PhischDotOrg/stm32f1-blinkenbike/README.md

# stm32f1-blinkenbike
Blinkenlight for Kids Bicycle based on a STM32F1 "Blue Pill" Board using an STM32F103 µC along with an WS2812b Strip.

# How to build
See the documentation for the common reposority at [https://github.com/PhischDotOrg/stm32-common](https://github.com/PhischDotOrg/stm32-common).
