PhischDotOrg/stm32f1-blinkenbike/hw/BlinkenBike.pdf

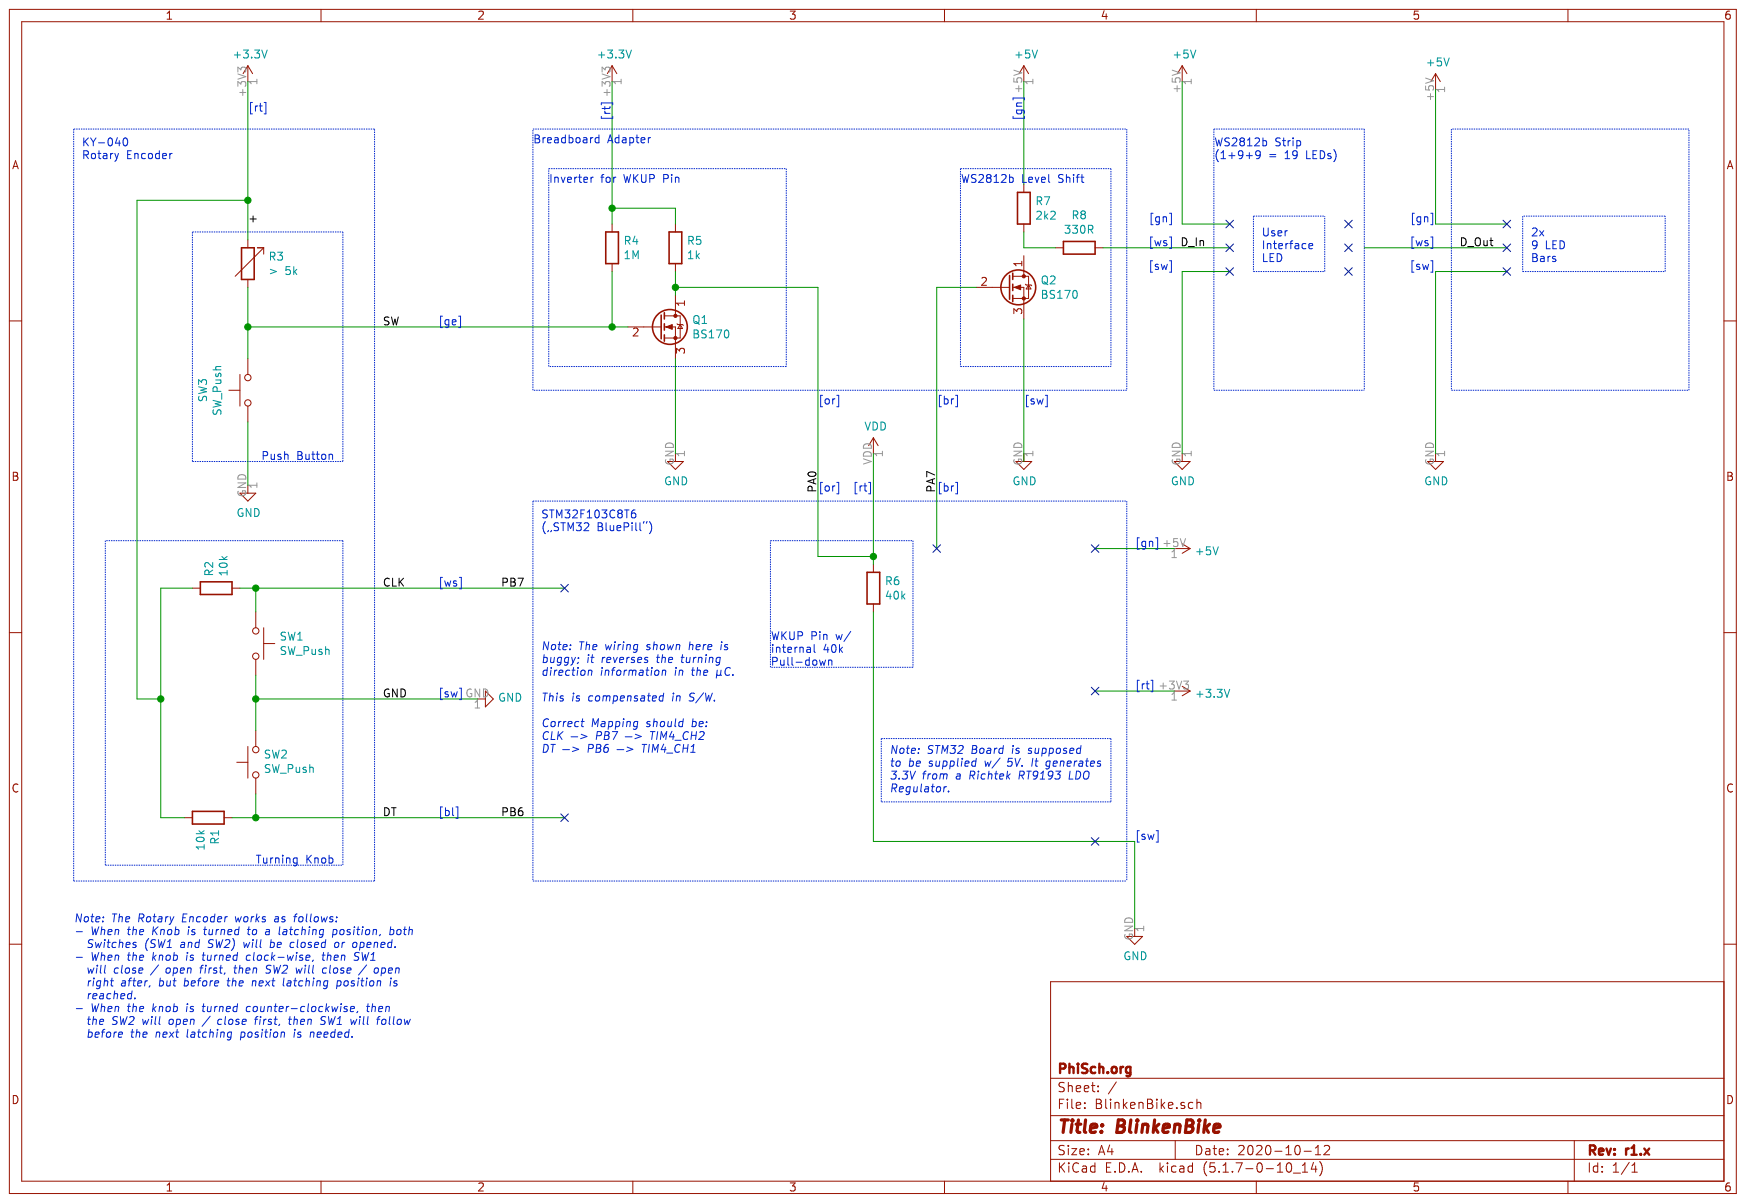
[picture p1: page 1]
