PhischDotOrg/stm32f1-blinkenbike/hw/BlinkenBike.sch

## KiCad design hw/BlinkenBike.sch (2020-10-13)

Schematic: BlinkenBike.sch

Parts:
Q1: BS170
Q2: BS170; TO-92_Inline
R1, R2: 10k
R3: > 5k
R4: 1M
R5: 1k
R6: 40k
R7: 2k2
R8: 330R
SW1, SW2, SW3: SW_Push

Notes on the sheet:
KY-040 Rotary Encoder
WS2812b Level Shift
[gn]
[ws]
[sw]
[br]
STM32F103C8T6 („STM32 BluePill“)
[rt]
[or]
Inverter for WKUP Pin
Breadboard Adapter
WS2812b Strip (1+9+9 = 19 LEDs)
WKUP Pin w/ internal 40k Pull-down
[ge]
[bl]
Turning Knob
Push Button
Note: STM32 Board is supposed to be supplied w/ 5V. It generates 3.3V from a Richtek RT9193 LDO Regulator.
User Interface LED
2x 9 LED Bars
Note: The Rotary Encoder works as follows: - When the Knob is turned to a latching position, both Switches (SW1 and SW2) will be closed or opened. - When the knob is turned clock-wise, then SW1 will close / open first, then SW2 will close / open right after, but before the next latching position is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
Note: The wiring shown here is buggy; it reverses the turning direction information in the µC. This is compensated in S/W. Correct Mapping should be: CLK —> PB7 —> TIM4_CH2 DT —> PB6 —> TIM4_CH1
