PhischDotOrg/stm32f1-blinkenbike/BlinkenBike.hpp

/*-
 * $Copyright$
-*/

#ifndef _BLINKENBIKE_HPP_BEF35430_91D6_4F5E_9587_EF88B244E219
#define _BLINKENBIKE_HPP_BEF35430_91D6_4F5E_9587_EF88B244E219

#include <phisch/log.h>

#include <FreeRTOS.h>

/*****************************************************************************/
template<
    typename LedStripT
>
class
BlinkenBikeT {
    enum class InputMode_t : uint8_t {
        e_Color,                // Turning Knob will change color of LEDs.
        e_Brightness,           // Turning Knob will change Brightness of LEDs.
        e_Speed,                // Turning Knob will change speed of Animation.
    };

    enum class OutputMode_t : uint8_t {
        e_Solid,                // Dauerlicht
        e_Flash,                // Blinken
        e_UpDownSynchronous,    // Hoch/Runter gleiche Richtung
        e_UpDownOpposite,       // Hoch/Runter gegenlaeufig
        e_Upwards,              // Nur Hoch
        e_Downwards,            // Nur Runter
        e_EvenOdd,              // Blinken m. jeder zweiten LED
    };

    typedef struct State_s {
        OutputMode_t            m_outputMode;
        InputMode_t             m_inputMode;
        Pixel::HSV::Hue         m_stateColor;
        uint8_t                 m_animationIdx;
    } State_t;

    static constexpr unsigned   m_uiLed = 0;
    static constexpr State_t    m_states[] __attribute__((aligned(4), section(".fixeddata"))) = {
        { .m_outputMode = OutputMode_t::e_Solid,                .m_inputMode = InputMode_t::e_Color,        .m_stateColor = Pixel::HSV::Hue::e_Red,         .m_animationIdx = 0 },
        { .m_outputMode = OutputMode_t::e_Solid,                .m_inputMode = InputMode_t::e_Brightness,   .m_stateColor = Pixel::HSV::Hue::e_Orange,      .m_animationIdx = 0 },
        { .m_outputMode = OutputMode_t::e_Flash,                .m_inputMode = InputMode_t::e_Speed,        .m_stateColor = Pixel::HSV::Hue::e_Yellow,      .m_animationIdx = 0 },
        { .m_outputMode = OutputMode_t::e_UpDownSynchronous,    .m_inputMode = InputMode_t::e_Speed,        .m_stateColor = Pixel::HSV::Hue::e_Green,       .m_animationIdx = 1 },
        { .m_outputMode = OutputMode_t::e_UpDownOpposite,       .m_inputMode = InputMode_t::e_Speed,        .m_stateColor = Pixel::HSV::Hue::e_Turquoise,   .m_animationIdx = 2 },
        { .m_outputMode = OutputMode_t::e_Upwards,              .m_inputMode = InputMode_t::e_Speed,        .m_stateColor = Pixel::HSV::Hue::e_Blue,        .m_animationIdx = 3 },
        { .m_outputMode = OutputMode_t::e_Downwards,            .m_inputMode = InputMode_t::e_Speed,        .m_stateColor = Pixel::HSV::Hue::e_Purple,      .m_animationIdx = 4 },
        { .m_outputMode = OutputMode_t::e_EvenOdd,              .m_inputMode = InputMode_t::e_Speed,        .m_stateColor = Pixel::HSV::Hue::e_Magenta,     .m_animationIdx = 5 },
    };
    static constexpr unsigned   m_nStates = sizeof(m_states) / sizeof(m_states[0]);

    static constexpr unsigned   m_maxBrightness = 64;

    LedStripT &                 m_ledStrip;
    unsigned                    m_currentState;

    Pixel::HSV                  m_uiHsv;
    bool                        m_uiChanged;

    Pixel::HSV                  m_hsvColor;
    Pixel::RGB                  m_rgbColor;
    bool                        m_colorChanged;

    int8_t                      m_counter;
    static constexpr uint8_t    m_maxCounter = 40;

    int8_t                      m_speed;
    static constexpr uint8_t    m_minSpeed = 1;
    static constexpr uint8_t    m_maxSpeed = (m_maxCounter / 3) + 1;

    /* Flash State */
    bool                        m_flash;

    /* Flash States */
    static constexpr uint16_t  __attribute__((aligned(4), section(".fixeddata"))) m_Flash[] = {
        0b000000000,
        0b111111111,
    };

    /* Up/Down States */
    static constexpr uint16_t  __attribute__((aligned(4), section(".fixeddata"))) m_UpDown[] = {
        0b100000000,
        0b010000000,
        0b001000000,
        0b000100000,
        0b000010000,
        0b000001000,
        0b000000100,
        0b000000010,
        0b000000001,
        0b000000010,
        0b000000100,
        0b000001000,
        0b000010000,
        0b000100000,
        0b001000000,
        0b010000000,
    };

    /* Even/Odd States */
    static constexpr uint16_t  __attribute__((aligned(4), section(".fixeddata"))) m_EvenOdd[] = {
        0b101010101,
        0b010101010,
    };

    typedef struct Animation_s {
        const uint16_t * const  m_states;
        unsigned                m_len;
        bool                    m_opposite;
    } Animation_t;

    static constexpr Animation_t __attribute__((aligned(4), section(".fixeddata"))) m_animations[] = {
        { .m_states = m_Flash,      .m_len = sizeof(m_Flash) / sizeof(m_Flash[0]),          .m_opposite = true },           // 0 -- e_Flash
        { .m_states = m_UpDown,     .m_len = sizeof(m_UpDown) / sizeof(m_UpDown[0]),        .m_opposite = false },          // 1 -- e_UpDownSynchronous
        { .m_states = m_UpDown,     .m_len = sizeof(m_UpDown) / sizeof(m_UpDown[0]),        .m_opposite = true },           // 2 -- e_UpDownOpposite
        { .m_states = m_UpDown,     .m_len = ((sizeof(m_UpDown) / sizeof(m_UpDown[0])) / 2) + 1,    .m_opposite = false },  // 3 -- e_Upwards
        { .m_states = m_UpDown,     .m_len = ((sizeof(m_UpDown) / sizeof(m_UpDown[0])) / 2) + 1,  .m_opposite = true },     // 4 -- e_Downwards
        { .m_states = m_EvenOdd,    .m_len = sizeof(m_EvenOdd) / sizeof(m_EvenOdd[0]),      .m_opposite = false },          // 5 -- e_EvenOdd
    };

    static_assert(((sizeof(m_UpDown) / sizeof(m_UpDown[0]))) == 16);
    static_assert(((sizeof(m_UpDown) / sizeof(m_UpDown[0]))) == 2 * ((LedStripT::SIZE / 2) - 1));
    static_assert(((sizeof(m_UpDown) / sizeof(m_UpDown[0])) / 2) + 1 == 9);
    static_assert(((sizeof(m_UpDown) / sizeof(m_UpDown[0])) / 2) + 1 == (LedStripT::SIZE / 2));

    const Animation_t * m_currentAnimation;
    uint8_t             m_animationIdx;

    template<typename ValueT, typename DistanceT>
    struct Knob_s {
        ValueT      m_previous;
        DistanceT   m_distance;

        Knob_s() : m_previous(0), m_distance(0) {

        }

        void update(ValueT p_new, bool p_directionCw) {
            /* Bugfix in stm32f1 v1.1: Error in Hardware Wiring made the turning direction the opposite. */
            m_distance = (p_directionCw ? -1 : 1);

            m_previous = p_new;
        }
 
        DistanceT distance(void) const {
            return m_distance;
        }

        static constexpr unsigned m_maxValue = (1 << ((sizeof(ValueT) * 8)) - 1) - 1;
        static_assert(sizeof(DistanceT) >= sizeof(ValueT));
    };

    struct Knob_s<uint8_t, int8_t>  m_knob;

    InputMode_t
    getCurrentInputMode(void) const {
        return m_states[m_currentState].m_inputMode;
    }

    OutputMode_t
    getCurrentOutputMode(void) const {
        return m_states[m_currentState].m_outputMode;
    }

    void
    changeBrightness(int8_t p_distance) {
        m_hsvColor.val = (m_hsvColor.val + p_distance) % m_maxBrightness;

        m_rgbColor = m_hsvColor;
        m_colorChanged = true;
    }

    void
    changeColor(int8_t p_distance) {
        m_hsvColor.hue += 160 * p_distance;

        m_rgbColor = m_hsvColor;
        m_colorChanged = true;
    }

    void
    changeSpeed(int8_t p_distance) {
        m_speed += 4 * p_distance;

        if (m_speed < m_minSpeed) {
            m_speed = m_minSpeed;
        } else if (m_speed > m_maxSpeed) {
            m_speed = m_maxSpeed;
        }
    }

    void
    refreshSolid(void) {
        if (m_colorChanged) {
            for (unsigned idx = 1; idx < LedStripT::SIZE; idx++) {
                m_ledStrip.setPixel(idx, m_rgbColor);
            }
            m_colorChanged = false;
        }
    }

    void
    refreshUi(void) {
        if (m_uiChanged) {
            m_ledStrip.setPixel(m_uiLed, m_uiHsv);
            m_uiChanged = false;
        }
    }

    void
    refreshFlash(void) {
        if (m_counter == m_maxCounter) {
            if (m_flash) {
                for (unsigned idx = 1; idx < LedStripT::SIZE; idx++) {
                    m_ledStrip.setPixel(idx, m_rgbColor);
                }
            } else {
                for (unsigned idx = 1; idx < LedStripT::SIZE; idx++) {
                    m_ledStrip.setPixel(idx, 0);
                }
            }

            m_flash = !m_flash;
        }
    }

    void
    refreshAnimation(void) {
        if (m_counter != m_maxCounter) return;

        static_assert((LedStripT::SIZE / 2) == 9);

        unsigned left, right;

        for (unsigned idx = 0; idx < (LedStripT::SIZE / 2); idx++) {
            left = 1 + idx;

            if (m_currentAnimation->m_opposite == false) {
                right = (LedStripT::SIZE / 2) + left;
            } else {
                right = (LedStripT::SIZE - 1) - idx;
            }

            if ((m_currentAnimation->m_states[m_animationIdx]) & (1 << idx)) {
                m_ledStrip.setPixel(left, m_rgbColor);
                m_ledStrip.setPixel(right, m_rgbColor);
            } else {
                m_ledStrip.setPixel(left, 0);
                m_ledStrip.setPixel(right, 0);
            }
        }

        m_animationIdx += 1;
        if (m_animationIdx >= m_currentAnimation->m_len) {
            m_animationIdx = 0;
        }
    }

    void
    refresh(void) {
        const OutputMode_t outputMode = getCurrentOutputMode();

        refreshUi();

        switch (outputMode) {
        case OutputMode_t::e_Solid:
            refreshSolid();
            break;
        case OutputMode_t::e_Flash:
            refreshFlash();
            break;
        default:
            refreshAnimation();
            break;
        }
    }

public:
    BlinkenBikeT(LedStripT &p_ledStrip)
      : m_ledStrip(p_ledStrip),
        m_currentState(0),
        m_uiHsv(static_cast<uint16_t>(m_states[m_currentState].m_stateColor), 255, m_maxBrightness / 2),
        m_uiChanged(true),
        m_hsvColor(0, 255, m_maxBrightness),
        m_rgbColor(m_hsvColor),
        m_colorChanged(true),
        m_counter(0),
        m_speed(m_minSpeed),
        m_flash(false),
        m_animationIdx(0)
    {
        static_assert(LedStripT::SIZE > 1, "LED Strip should be more than one LED long!");
        static_assert((LedStripT::SIZE % 2) == 1, "LED Strip should be 1 + an even number of LEDs long!");
        static_assert(m_nStates == 8);

        refresh();
    }

    void
    changeState(void) {
        m_currentState = (m_currentState + 1) % m_nStates;

        m_uiHsv = m_states[m_currentState].m_stateColor;
        m_uiChanged = true;

        m_colorChanged = true;
 
        m_currentAnimation = &m_animations[m_states[m_currentState].m_animationIdx];
        m_animationIdx = 0;

        refresh();
    }

    void
    blinkTick(void) {
        m_counter -= m_speed;

        if (m_counter < 0) {
            m_counter = m_maxCounter;
        }

        refresh();
    }

    void
    knobTurned(unsigned p_value, bool p_clockwise) {
        const InputMode_t inputMode = getCurrentInputMode();

        m_knob.update(p_value, p_clockwise);

        switch (inputMode) {
        case InputMode_t::e_Color:
            changeColor(m_knob.distance());
            break;
        case InputMode_t::e_Brightness:
            changeBrightness(m_knob.distance());
            break;
        case InputMode_t::e_Speed:
            changeSpeed(m_knob.distance());
            break;
        }
    }
};
/*****************************************************************************/

#endif /* _BLINKENBIKE_HPP_BEF35430_91D6_4F5E_9587_EF88B244E219 */
