PhischDotOrg/stm32f1-blinkenbike/(commit log)

2020-10-07 Move Rotary and Push Button Timer Functions to separate file.
2020-10-07 Use common/ on stm32f1 branch
2020-10-08 Remove outdated print
2020-10-11 Update common/ to tag "stm32f1-blinkenbike-v1.0"
2020-10-11 Work-around to adapt Knob Turning Direction to faulty Hardware wiring.
2020-10-12 Workaround to give SPI Transfer some time to settle on shutdown.
    [ShutdownHandler.hpp]
2020-10-13 Add Schematics for H/W Design.
    [BlinkenBike.sch]
